bouletmarc/BMBurner/Diagram/BMBurner V1.1.sch

## EAGLE design Diagram/BMBurner V1.1.sch (2019-03-08, last stored version)

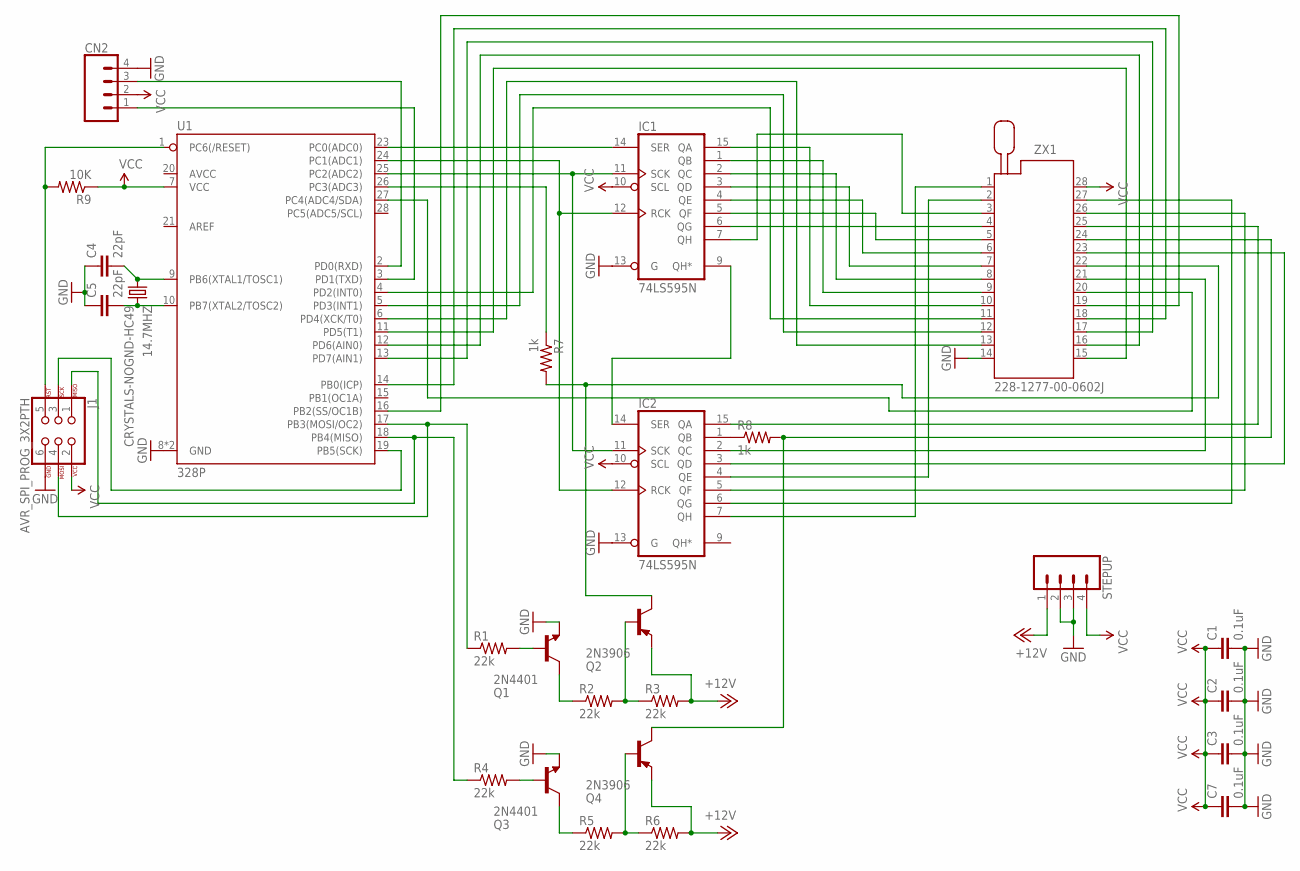
[picture p5: schematic BMBurner V1.1.sch]

Parts:
14.7MHZ: CRYSTALS-NOGND-HC49; HC49
C1, C2, C3, C7: 0.1uF; CAP-PTH-SMALL
C4, C5: 22pF; CAP-PTH-SMALL
CN2: CONN_04; 1X04
IC1, IC2: 74LS595N; DIL16
J1: AVR_SPI_PROG_3X2PTH; 2X3
Q1, Q3: 2N4401; TO92-EBC
Q2, Q4: 2N3906; TO92-EBC
R1, R2, R3, R4, R5, R6: 22k; 0204/5
R7, R8: 1k; 0204/5
R9: 10K; 0204/5
STEPUP: CONN_04; 1X04
U1: 328P; DIP28
ZX1: 228-1277-00-0602J

Connections:
+12V: Q2.E, Q4.E, R3.2, R6.2, STEPUP.1
GND: C1.2, C2.2, C3.2, C4.1, C5.1, C7.2, CN2.4, IC1.13 (G), IC2.13 (G), J1.6, Q1.E, Q3.E, STEPUP.2, STEPUP.3, U1.8 (GND), ZX1.14
unnamed: U1.27 (PC4(ADC4/SDA)), ZX1.20
unnamed: R7.1, U1.26 (PC3(ADC3))
unnamed: IC1.11 (SCK), IC2.11 (SCK), U1.25 (PC2(ADC2))
unnamed: IC2.4 (QE), ZX1.2
unnamed: Q2.C, R7.2, ZX1.22
unnamed: IC2.6 (QG), ZX1.27
unnamed: Q1.C, R2.1
unnamed: IC2.2 (QC), ZX1.21
unnamed: IC2.7 (QH), ZX1.1
unnamed: Q3.C, R5.1
unnamed: J1.5, R9.2, U1.1 (PC6(/RESET))
unnamed: 14.7MHZ.2, C5.2, U1.10 (PB7(XTAL2/TOSC2))
unnamed: CN2.1, U1.3 (PD1(TXD))
unnamed: 14.7MHZ.1, C4.2, U1.9 (PB6(XTAL1/TOSC1))
unnamed: J1.1, R4.1, U1.18 (PB4(MISO))
unnamed: CN2.3, U1.2 (PD0(RXD))
unnamed: U1.14 (PB0(ICP)), ZX1.18
unnamed: J1.4, R1.1, U1.17 (PB3(MOSI/OC2))
unnamed: J1.3, U1.19 (PB5(SCK))
unnamed: U1.5 (PD3(INT1)), ZX1.12
unnamed: U1.6 (PD4(XCK/T0)), ZX1.13
unnamed: U1.11 (PD5(T1)), ZX1.15
unnamed: U1.12 (PD6(AIN0)), ZX1.16
unnamed: U1.13 (PD7(AIN1)), ZX1.17
unnamed: Q1.B, R1.2
unnamed: U1.16 (PB2(SS/OC1B)), ZX1.19
unnamed: Q2.B, R2.2, R3.1
unnamed: Q3.B, R4.2
unnamed: Q4.B, R5.2, R6.1
unnamed: Q4.C, R8.2, ZX1.24
unnamed: IC2.1 (QB), R8.1
unnamed: IC2.15 (QA), ZX1.25
unnamed: IC1.12 (RCK), IC2.12 (RCK), U1.24 (PC1(ADC1))
unnamed: IC1.14 (SER), U1.23 (PC0(ADC0))
unnamed: IC1.9 (QH*), IC2.14 (SER)
unnamed: U1.4 (PD2(INT0)), ZX1.11
unnamed: IC1.15 (QA), ZX1.10
unnamed: IC1.1 (QB), ZX1.9
unnamed: IC1.2 (QC), ZX1.8
unnamed: IC1.3 (QD), ZX1.7
unnamed: IC1.4 (QE), ZX1.6
unnamed: IC1.5 (QF), ZX1.5
unnamed: IC1.6 (QG), ZX1.4
unnamed: IC1.7 (QH), ZX1.3
unnamed: IC2.3 (QD), ZX1.23
unnamed: IC2.5 (QF), ZX1.26
VCC: C1.1, C2.1, C3.1, C7.1, CN2.2, IC1.10 (SCL), IC2.10 (SCL), J1.2, R9.1, STEPUP.4, U1.7 (VCC), ZX1.28
