bouletmarc/BMBurner/Wiring/eeprom_burnerNew.sch

## EAGLE design Wiring/eeprom_burnerNew.sch (2017-11-20, last stored version)

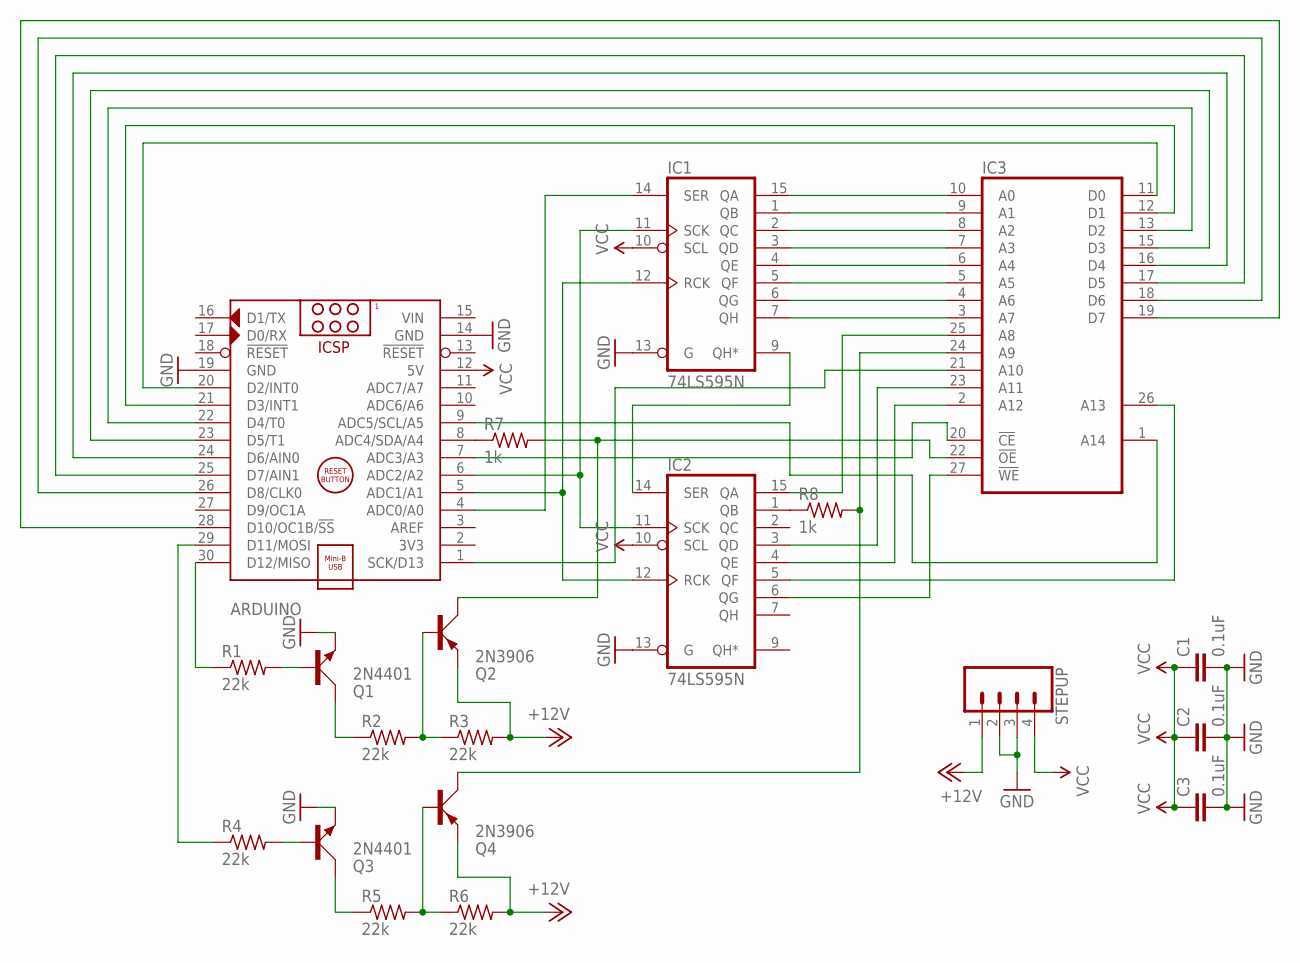
[picture p6: schematic eeprom_burnerNew.sch]

Parts:
ARDUINO: ARDUINO_NANO
C1, C2, C3: 0.1uF; CAP-PTH-SMALL
IC1, IC2: 74LS595N; DIL16
IC3: 2864; DIL28
Q1, Q3: 2N4401; TO18A
Q2, Q4: 2N3906; TO92D
R1, R2, R3, R4, R5, R6: 22k; 0207/10
R7, R8: 1k; 0207/10
STEPUP: CONN_04; 1X04

Connections:
+12V: Q2.E, Q4.E, R3.2, R6.2, STEPUP.1
GND: ARDUINO.14 (GND), ARDUINO.19 (GND), C1.2, C2.2, C3.2, IC1.13 (G), IC2.13 (G), Q1.E, Q3.E, STEPUP.2, STEPUP.3
unnamed: ARDUINO.7 (ADC3/A3), IC3.20 (!CE)
unnamed: ARDUINO.29 (D11/MOSI), R4.1
unnamed: ARDUINO.6 (ADC2/A2), IC1.11 (SCK), IC2.11 (SCK)
unnamed: IC2.4 (QE), IC3.2 (A12)
unnamed: ARDUINO.9 (ADC5/SCL/A5), IC3.1 (A14)
unnamed: IC3.22 (!OE), Q2.C, R7.2
unnamed: IC2.6 (QG), IC3.27 (!WE)
unnamed: Q1.C, R2.1
unnamed: ARDUINO.1 (SCK/D13), IC3.21 (A10)
unnamed: ARDUINO.30 (D12/MISO), R1.1
unnamed: Q3.C, R5.1
unnamed: ARDUINO.8 (ADC4/SDA/A4), R7.1
unnamed: Q1.B, R1.2
unnamed: Q2.B, R2.2, R3.1
unnamed: Q3.B, R4.2
unnamed: Q4.B, R5.2, R6.1
unnamed: IC3.24 (A9), Q4.C, R8.2
unnamed: IC2.1 (QB), R8.1
unnamed: IC2.15 (QA), IC3.25 (A8)
unnamed: ARDUINO.5 (ADC1/A1), IC1.12 (RCK), IC2.12 (RCK)
unnamed: ARDUINO.4 (ADC0/A0), IC1.14 (SER)
unnamed: IC1.9 (QH*), IC2.14 (SER)
unnamed: ARDUINO.20 (D2/INT0), IC3.11 (D0)
unnamed: ARDUINO.21 (D3/INT1), IC3.12 (D1)
unnamed: ARDUINO.22 (D4/T0), IC3.13 (D2)
unnamed: ARDUINO.23 (D5/T1), IC3.15 (D3)
unnamed: ARDUINO.24 (D6/AIN0), IC3.16 (D4)
unnamed: ARDUINO.25 (D7/AIN1), IC3.17 (D5)
unnamed: ARDUINO.26 (D8/CLK0), IC3.18 (D6)
unnamed: ARDUINO.28 (D10/OC1B/!SS), IC3.19 (D7)
unnamed: IC1.15 (QA), IC3.10 (A0)
unnamed: IC1.1 (QB), IC3.9 (A1)
unnamed: IC1.2 (QC), IC3.8 (A2)
unnamed: IC1.3 (QD), IC3.7 (A3)
unnamed: IC1.4 (QE), IC3.6 (A4)
unnamed: IC1.5 (QF), IC3.5 (A5)
unnamed: IC1.6 (QG), IC3.4 (A6)
unnamed: IC1.7 (QH), IC3.3 (A7)
unnamed: IC2.3 (QD), IC3.23 (A11)
unnamed: IC2.5 (QF), IC3.26 (A13)
VCC: ARDUINO.12 (5V), C1.1, C2.1, C3.1, IC1.10 (SCL), IC2.10 (SCL), STEPUP.4
