bouletmarc/BMBurner/Wiring/BMBurner V1.0_TOP.JPG

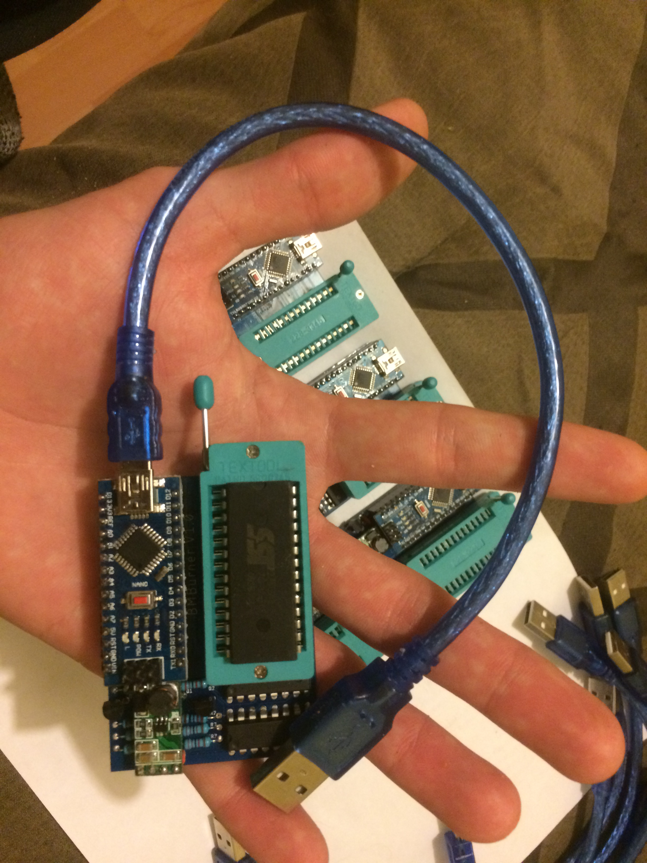
Wiring/BMBurner V1.0_TOP.JPG
