bouletmarc/BMBurner/Wiring/BMBurner V1.1_BOTTOM.jpg

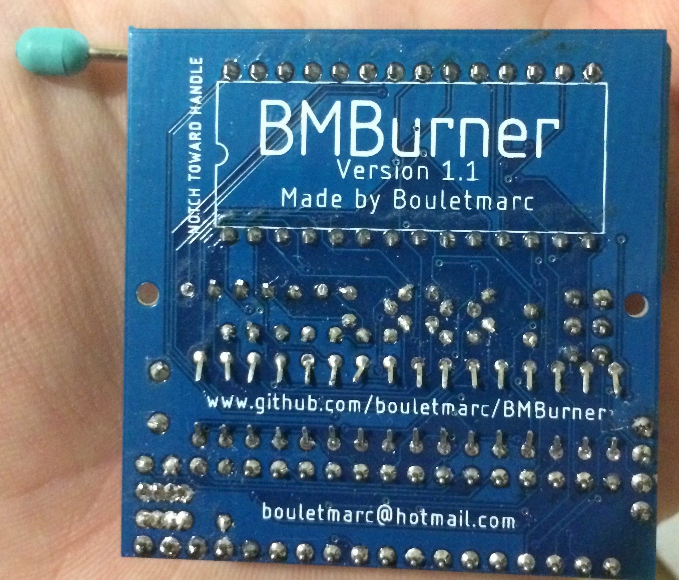
Wiring/BMBurner V1.1_BOTTOM.jpg
