bouletmarc/BMBurner/Wiring/BMBurner V1.1_TOP.JPG

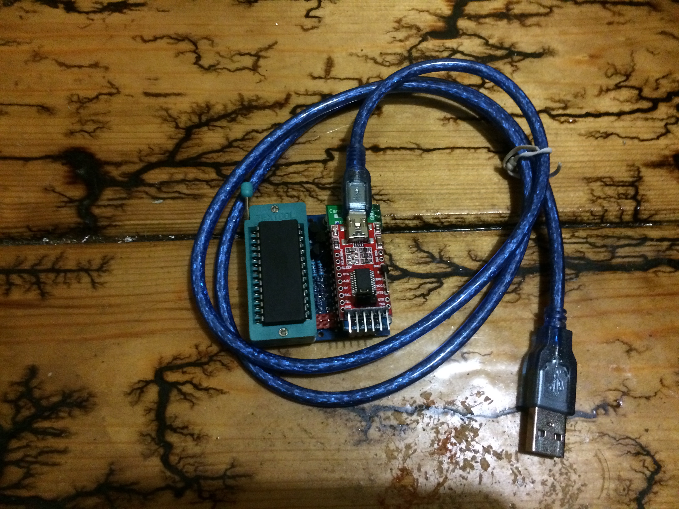
Wiring/BMBurner V1.1_TOP.JPG
