bouletmarc/BMBurner/Wiring/BMBurner_V2.3_Bottom.jpg

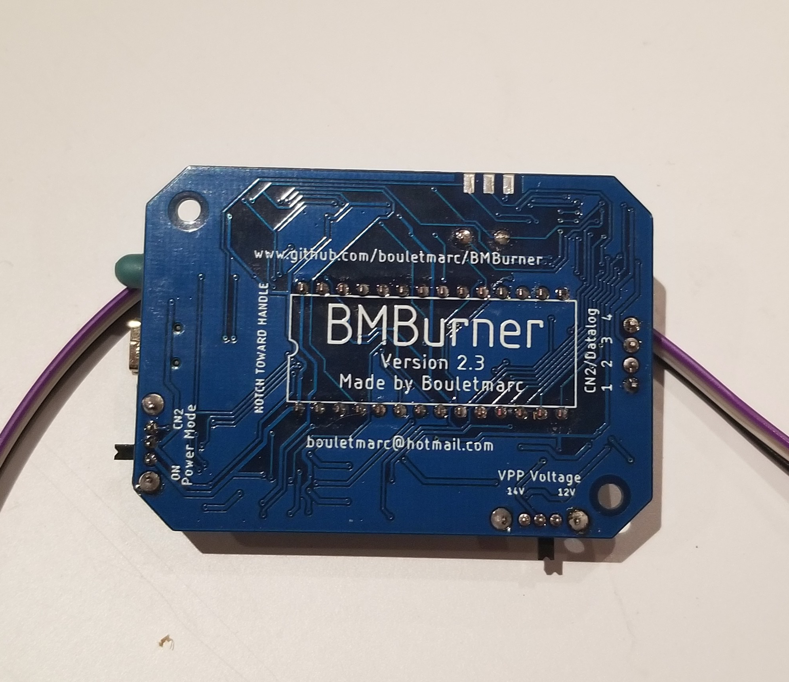
Wiring/BMBurner_V2.3_Bottom.jpg
