bouletmarc/BMBurner/(threads)

Thread 1 (2018-09-08):

tried to assembled

tycs03, 2018-09-08:
tried to assemble the burner can't get it to work. don't really know whats wrong. also can i ask is Q1 and Q2  emitter connected to ground ? i try the circuit and nothing happens when i try to blank check software says its not blank. but its a new chip. when i try to write software says write ok but when verify buffer not the same.

please  help

thanks

tycs03, 2018-09-09:
ok so i have done further testing, i found that my transistors were installed incorrectly Q1 and Q2. after rectifying that, i have tested the programmer and found that it does not work with 29c256. however it does work with 27sf512. I hope this issue could be fixed as i have built this programmer mainly for atmel 29c256

tested with a new atmel 29c256 when trying to check blank software says 'ITS NOT BLANK' when try to write software says " WRITE SUCCESS" when i try to verify " BUFFER DOES NOT MATCH" when i try to read the chip is indeed blank.

thank you

bouletmarc, 2018-09-09:
this project was mainly done for 27SF512 and Im not working on it anymore, well atleast for now, It might get updated one day, but now the development are kinda stopped

Closed 2018-09-09.

Thread 2 (2018-10-21):

Unable to erase W27C512

StormTrooper, 2018-10-21:
I''m using the latest version of bmburner and I think I found a bug.

Selecting W27c512 and select erase chip. It does through the motions and says chip is erased but when I blank check the chip, its not black.

If however  I run arduino and send 5ECS through the console then the chip is successfully blanked.

Are you able to reproduce this issue?

bouletmarc, 2020-01-22:
the new BMBurner can now do W27C512

Closed 2020-01-22.

Thread 3 (2019-02-17):

Why the 27C512 etc chips are read-only with BMBurner?

iddq, 2019-02-17:

StormTrooper, 2019-05-26:
Also wonder why. Have you been able to find a workaround?

bouletmarc, 2020-01-22:
the circuit of the BMBurner doesn't allow that, it require 6.5V on the VCC pin and 12.5V on the VPP pin to program a 27C256 chip, it may eventually exist in a next revision

Closed 2020-01-22.

Thread 4 (2019-03-26):

Random connection

boomienutcake, 2019-03-26:
Great tool! Works fantastic when it connects, but having issues.
I've made this project both on a breadboard using a CH340G Nano, and spun my own v1.0 through OSHPark using an on-board 328p, booster circuit and FT231X. Both have issues connecting to the software, taking at least 4 cycles to connect, or never connecting.
I've messed with the latency a little to no avail. Does this happen normally with the software, or is there something I'm missing?

Closed 2020-01-22.

Thread 5 (2020-01-16):

burning 27SF512

donanjana, 2020-01-16:
burning  27SF512 get success. when i read it, it gets wrong values in different memory locations when comparing it with original bin file. every  read access get different values when comparing it with previous read.

bouletmarc, 2020-01-17:
did you made the project from your own self or this is a BMBurner device your purchased from me, is this is a BMBurner device, please specifify which BMBurner Version you got

Closed 2020-01-22.

Thread 6 (2020-05-09):

My chip burner version 1.1

f22b2jesus, 2020-05-09:
Downloaded driver and all still wont connect

bouletmarc, 2020-05-11:
the bmburner v1.1 you got may have become faulty overtime since this unit aren't having any kind of protection for high current protection or for short circuit. If anything have sorted the 5v to the grn lately on the bmburner it is likely to be blown. You can possibly try to replace the ftdi adapter itself but I dont suspect anything to change.

I have added an auto-reset protection fuse on the bmburners of the v2.0 and above to avoid this failure overtime. I would suggest to get your bmburner v1.1 replace by the newest one I got available. Send me a message to my email to discuse about the discount for the replacement burner if you are willing to replace it.

Also please can you report any others issue in the futur over my email that is specified on the back of the bmburner, email : bouletmarc@hotmail.com

Thank you :)

Closed 2020-05-11.
