bouletmarc/BMBurner/(commit log)

2017-11-20 BMBurner V1.0
    [eeprom_burnerNew.sch]
2017-12-04 BMBurner Tool V2.1.1 (27C256+Moates Compatibility)
    Auto Update
    Moates Burn1/Burn2 Compatibility
    Added 27C256
    Added Serial Reconnect button
2017-12-04 Project Files (Board V1.0 + Firmware V1.1)
    Project files for
    BMBurner PCB Board V1.0
    Firmware V1.1 Update :
    -Compatibility 27C256
    -Compatibilty with some original programming software like ECTUNE
2017-12-22 Project Files (Board V1.0 + Firmware V1.2)
2019-03-08 Project Files (Board V1.1 + Firmware V1.3)
2019-03-08 Wiring diagram V1.1
2019-03-08 Eagle Schematics V1.0 + V1.1
    [BMBurner V1.0.sch, BMBurner V1.1.sch]
